hfatih/arduino-sensor-istasyonu/(commit log)

2026-10-13 Arduino sensör istasyonu: Uno + BME280/BMP280 + DHT11 + OLED ve Windows paneli
    OLED 30 sn bilgisayar (CPU/RAM/GPU), 5 sn sensör sayfası arasında döner.
    Tkinter paneli ve penceresiz gönderici modu dahil.
2026-10-14 Fix lost serial bytes, fit dashboard to screen, refresh screenshot
    The Uno cannot read serial for ~150 ms while it redraws the OLED, so two
    lines arriving close together overflowed its 64-byte receive buffer and
    lost bytes mid-line (unknown_cmd / line_too_long, measured on hardware).
    The PC now waits for the board's first message and leaves 330 ms between
    lines. Rejected lines are echoed in the error message for diagnosis.
    Dashboard opens at a size that fits its content on high-DPI screens, long
    GPU names no longer widen the window, and charts scale to the data they
    have instead of always spanning 10 minutes.
    [sensor_istasyonu.ino, sensor_panel.py]
